amchagas/CellComunicationLab/media/assembly/clean/Drivers unlinked.tif

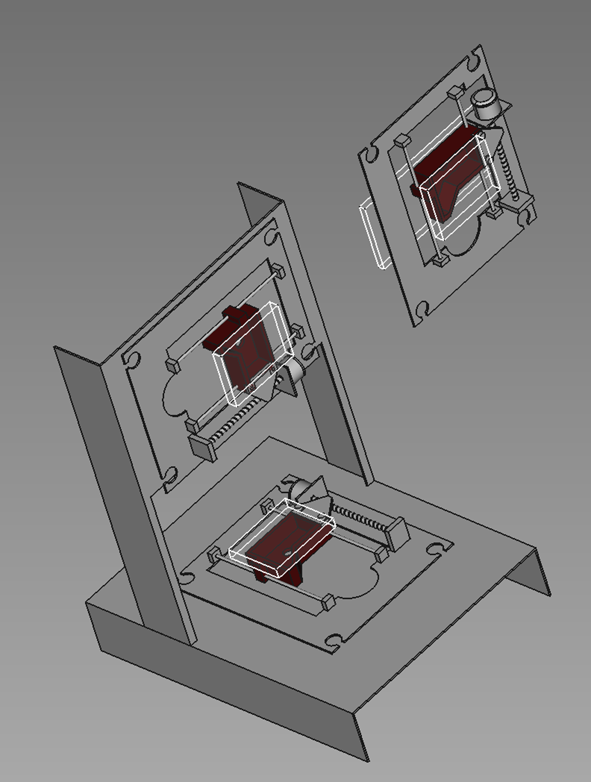
media/assembly/clean/Drivers unlinked.tif
