amchagas/CellComunicationLab/media/assembly/clean/Eletronic modules.tif

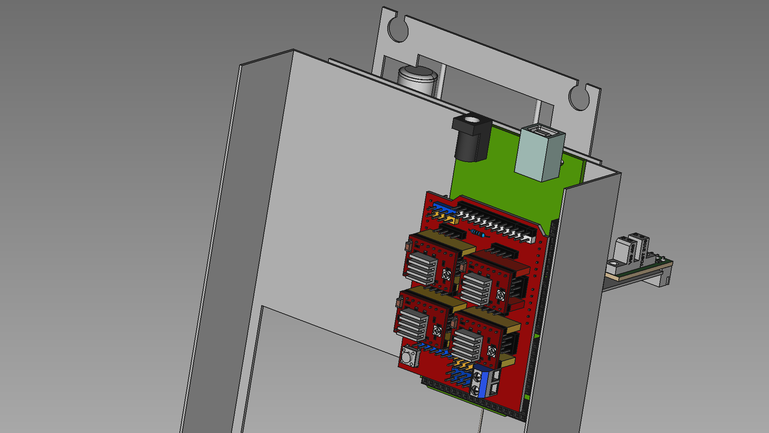
media/assembly/clean/Eletronic modules.tif
