amchagas/CellComunicationLab/media/assembly/clean/Frontal view.tif

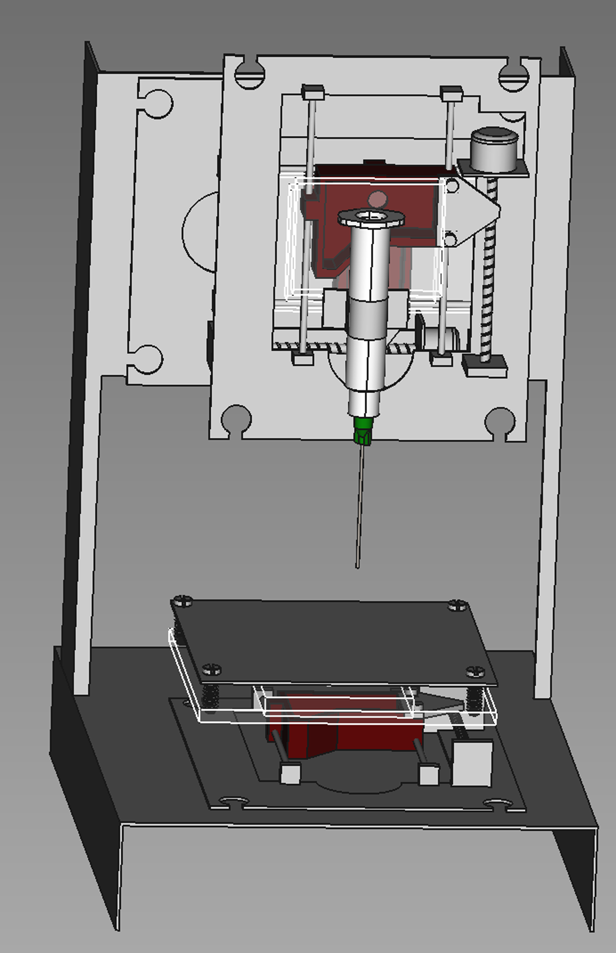
media/assembly/clean/Frontal view.tif
