amchagas/CellComunicationLab/media/assembly/clean/Initial assembly.tif

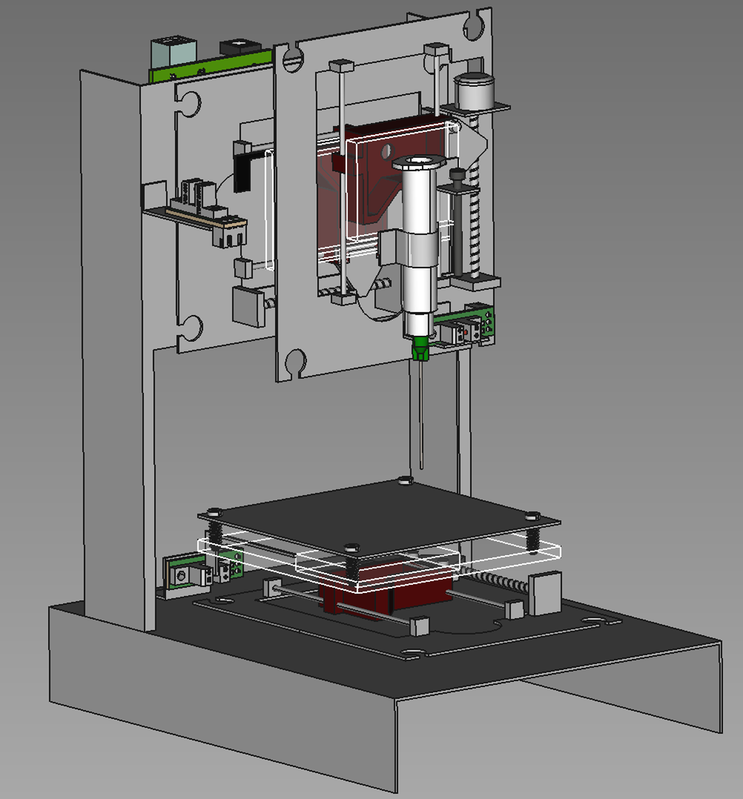
media/assembly/clean/Initial assembly.tif
