amchagas/CellComunicationLab/media/assembly/clean/Linked drivers.tif

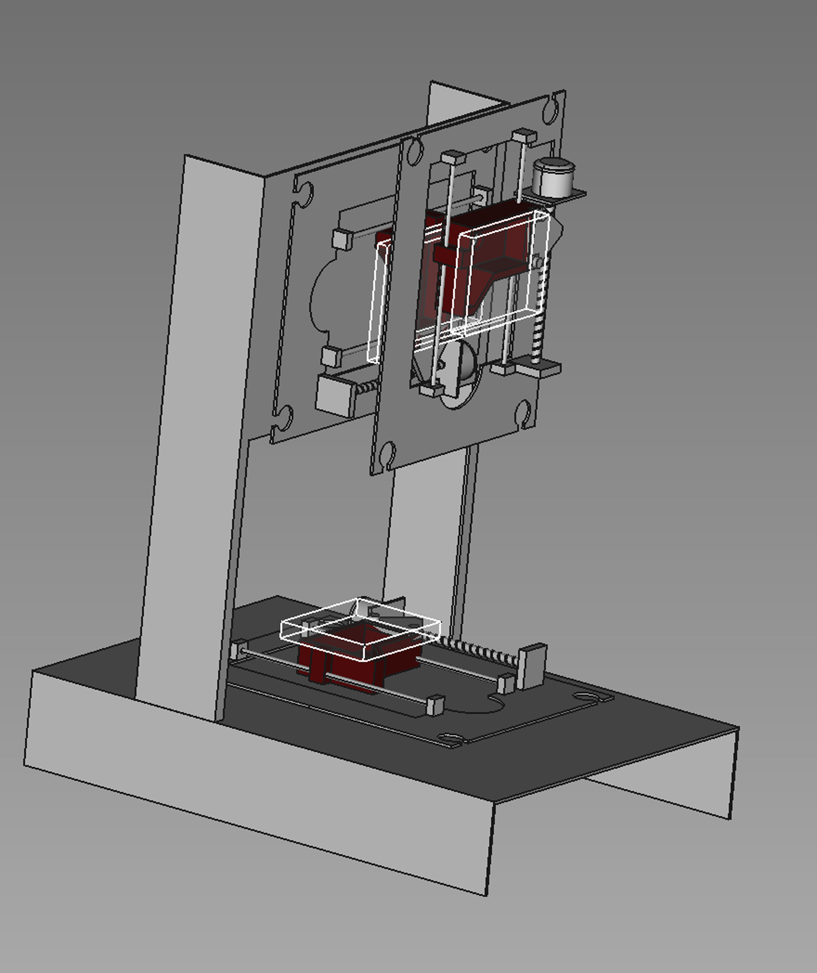
media/assembly/clean/Linked drivers.tif
