amchagas/CellComunicationLab/media/assembly/clean/Print table.tif

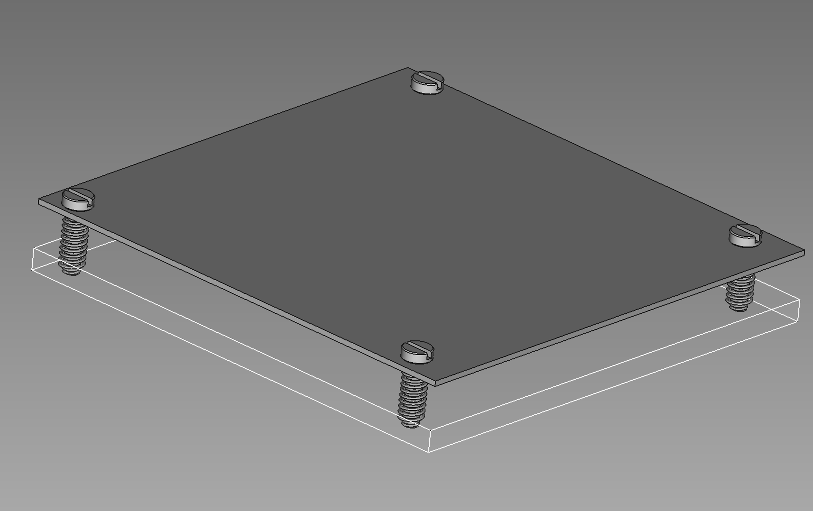
media/assembly/clean/Print table.tif
