amchagas/CellComunicationLab/media/assembly/legend/1 - Gatry image.tif

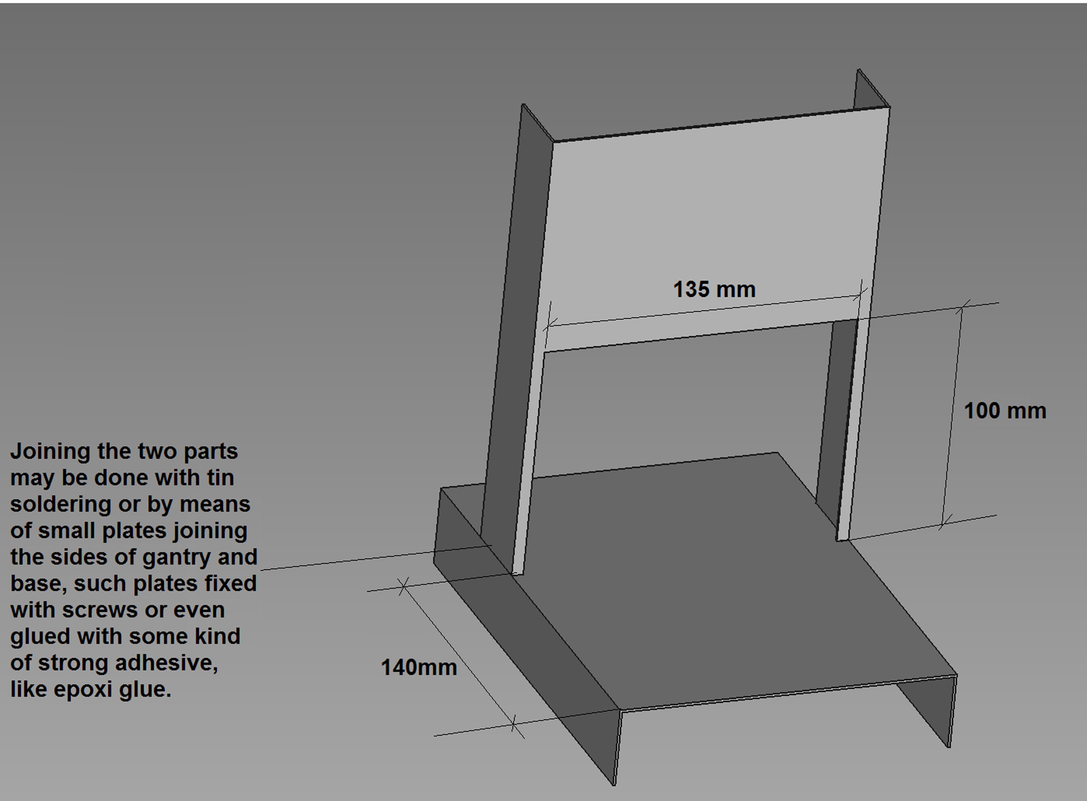
media/assembly/legend/1 - Gatry image.tif
