amchagas/CellComunicationLab/media/assembly/legend/2 - Driver view.tif

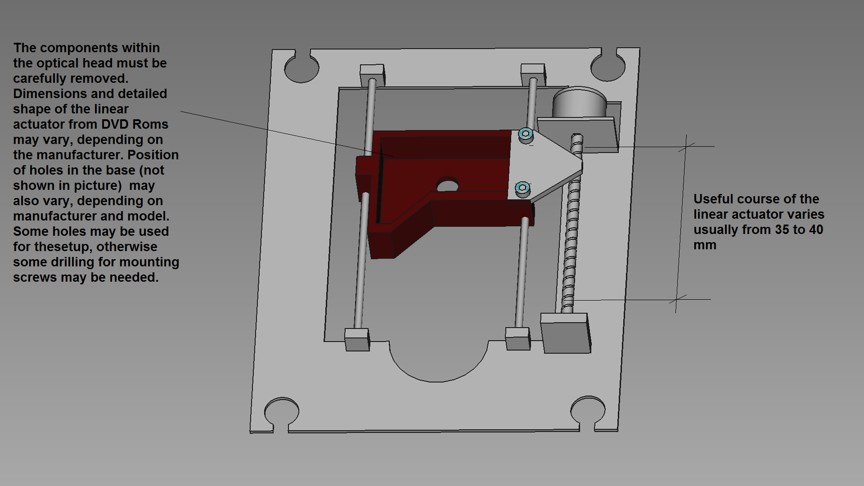
media/assembly/legend/2 - Driver view.tif
