amchagas/CellComunicationLab/media/assembly/legend/3-Drivers view compete axis.tif

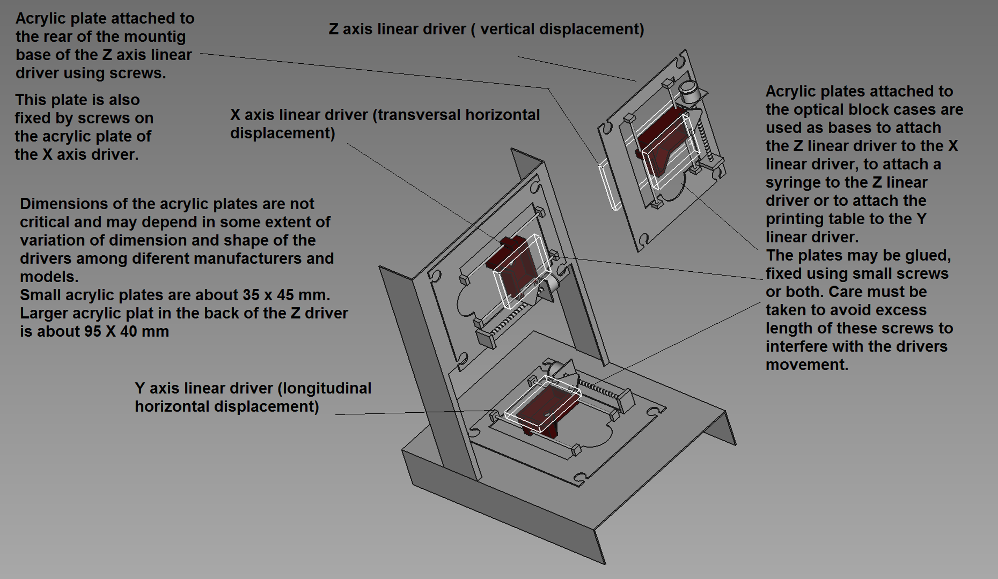
media/assembly/legend/3-Drivers view compete axis.tif
