amchagas/CellComunicationLab/media/assembly/legend/4 - Driver linked lateral view.tif

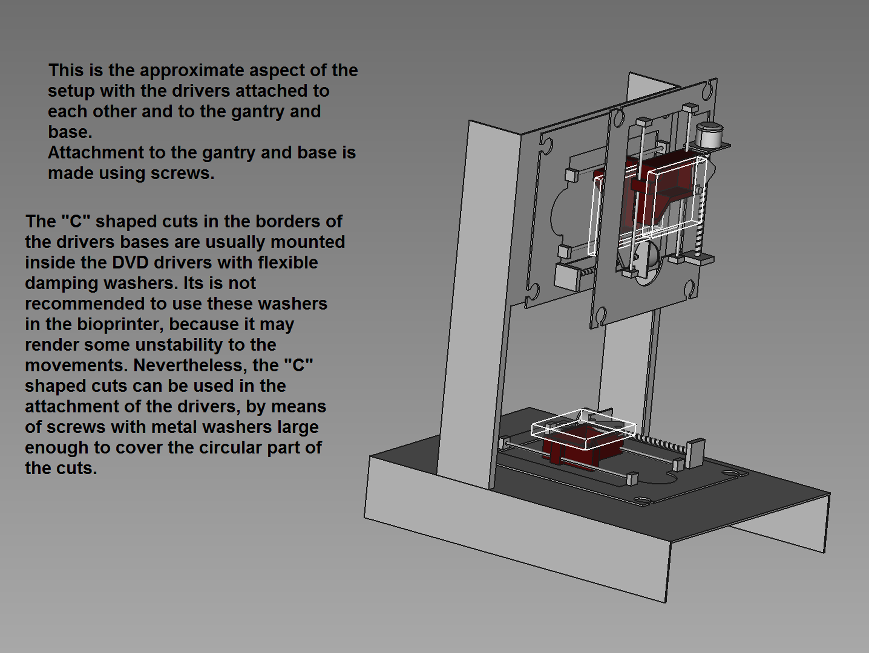
media/assembly/legend/4 - Driver linked lateral view.tif
