amchagas/CellComunicationLab/media/assembly/legend/5. Detailed table view.tif

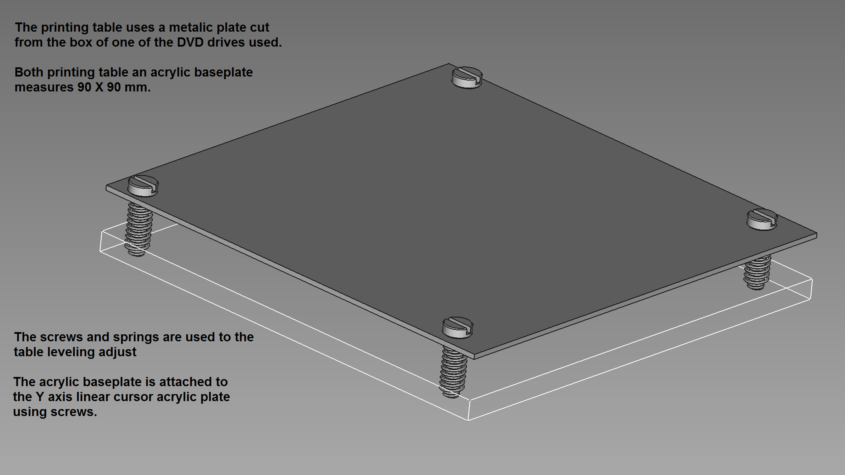
media/assembly/legend/5. Detailed table view.tif
