amchagas/CellComunicationLab/media/assembly/legend/6 - Initial assembly.tif

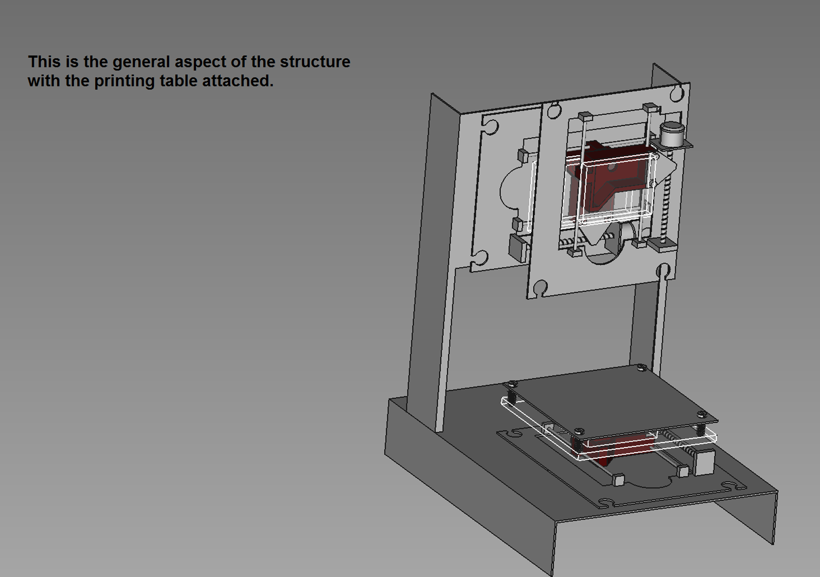
media/assembly/legend/6 - Initial assembly.tif
