amchagas/CellComunicationLab/media/assembly/legend/7 - Frontal view of bioprinter assembly.tif

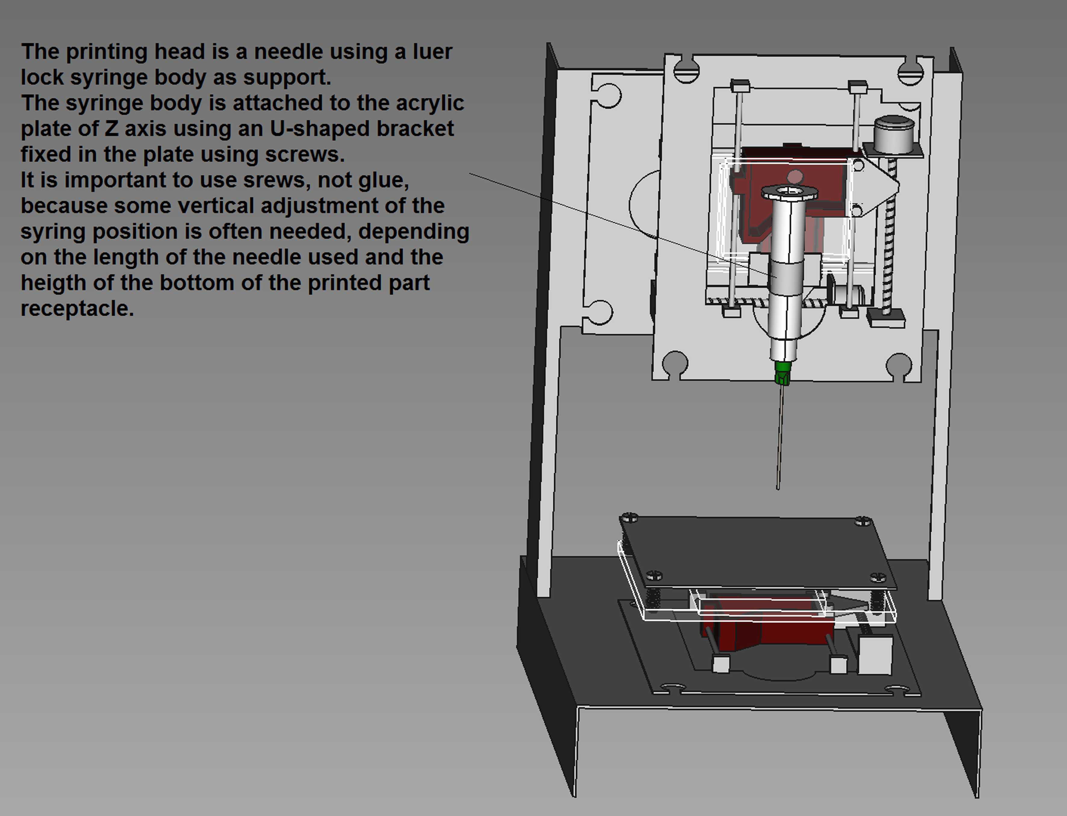
media/assembly/legend/7 - Frontal view of bioprinter assembly.tif
