amchagas/CellComunicationLab/media/assembly/legend/8 - Eletronic module.tif

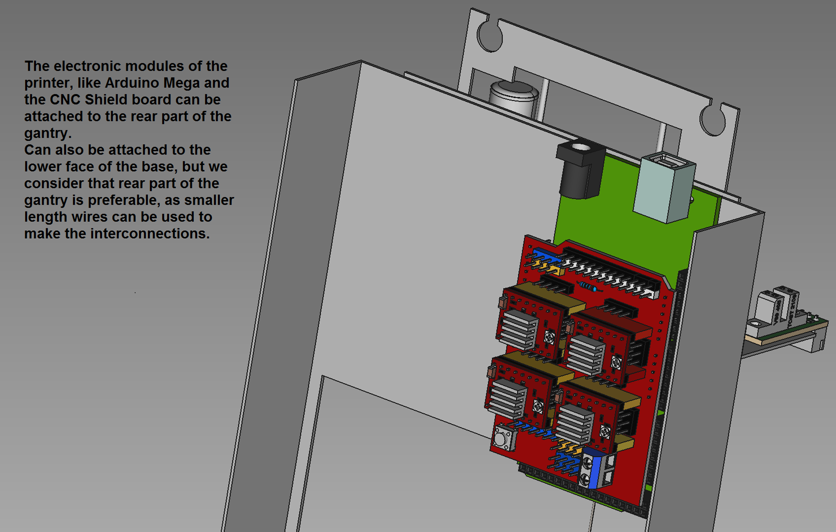
media/assembly/legend/8 - Eletronic module.tif
