amchagas/CellComunicationLab/media/assembly/legend/9 -End-stop sensors.tif

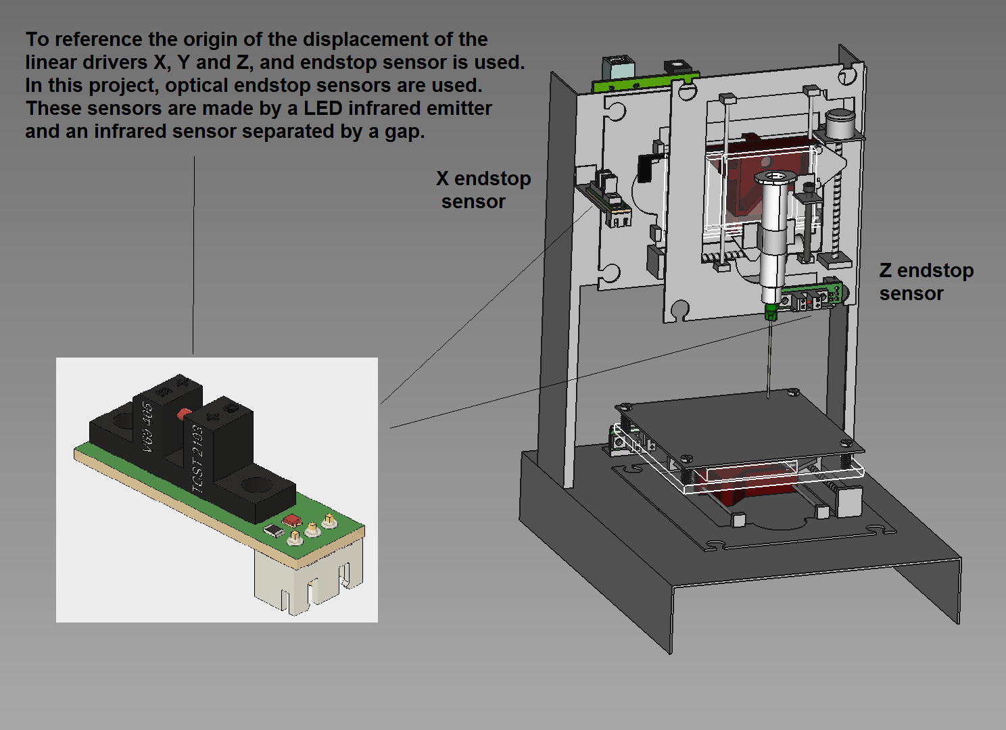
media/assembly/legend/9 -End-stop sensors.tif
