amchagas/CellComunicationLab/media/assembly/legend/10 -XZ axis end-stop sensors.tif

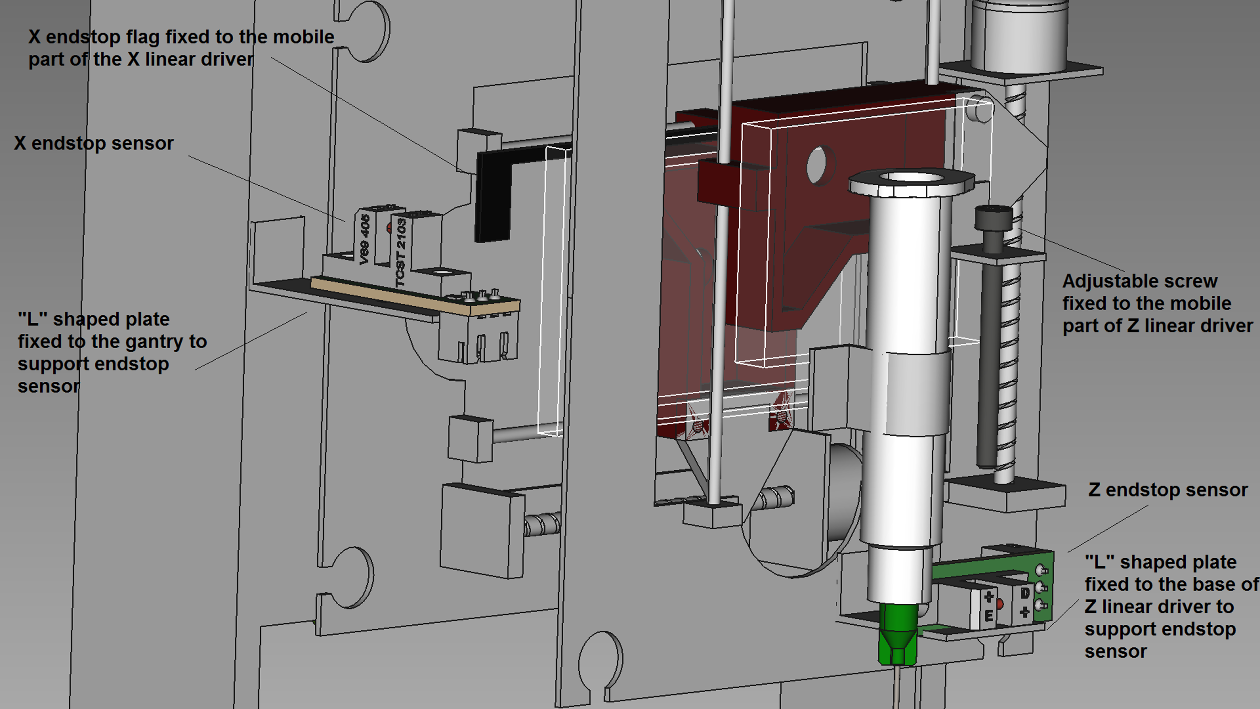
media/assembly/legend/10 -XZ axis end-stop sensors.tif
