amchagas/CellComunicationLab/media/assembly/legend/11 -Y axis end-stop sensor.tif

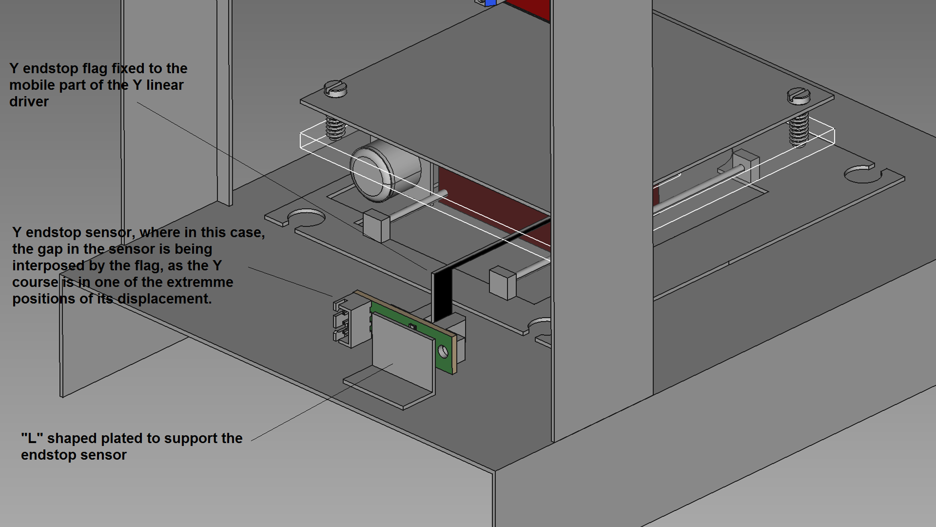
media/assembly/legend/11 -Y axis end-stop sensor.tif
