amchagas/CellComunicationLab/media/assembly/legend/12 - XYZ end-stop sensors position.tif

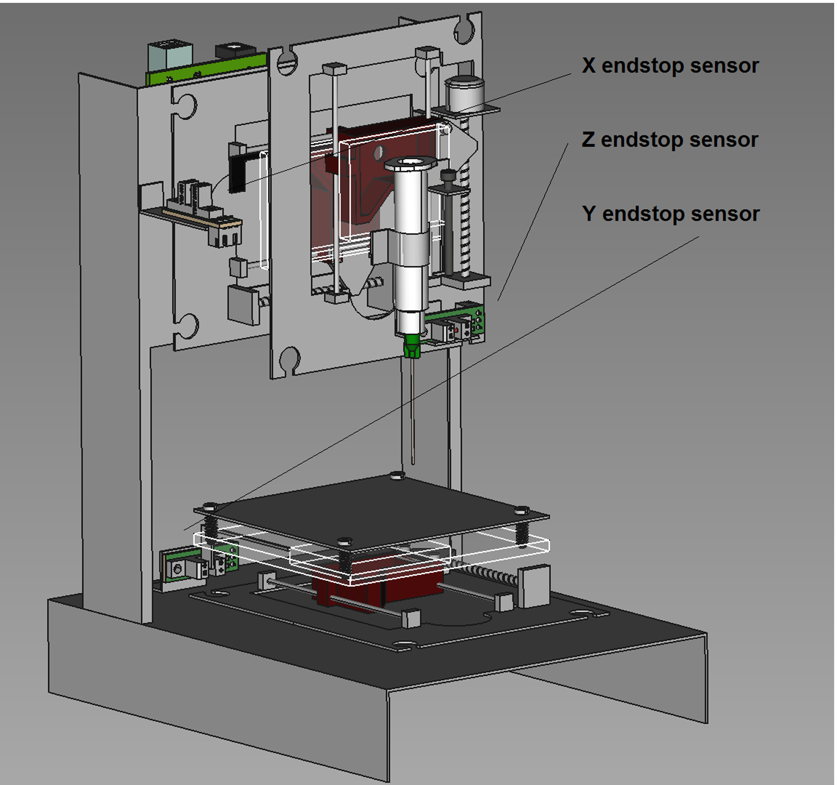
media/assembly/legend/12 - XYZ end-stop sensors position.tif
