amchagas/CellComunicationLab/software/Repetier/Configuration.h

#define CONFIGURATION_H
#define NUM_EXTRUDER 1
#define MOTHERBOARD 33
#include "pins.h"
#define HOST_RESCUE 1
#undef FAN_BOARD_PIN
#define FAN_BOARD_PIN 9 //-1
#define BOARD_FAN_SPEED 255
#define BOARD_FAN_MIN_SPEED 0
#define FAN_THERMO_PIN -1
#define FAN_THERMO_MIN_PWM 128
#define FAN_THERMO_MAX_PWM 255
#define FAN_THERMO_MIN_TEMP 45
#define FAN_THERMO_MAX_TEMP 60
#define FAN_THERMO_THERMISTOR_PIN -1
#define FAN_THERMO_THERMISTOR_TYPE 0
#undef X_MIN_PIN
#define X_MIN_PIN 3
#undef Y_MIN_PIN
#define Y_MIN_PIN 14
#undef Z_MIN_PIN
#define Z_MIN_PIN 18
#undef X_MAX_PIN
#define X_MAX_PIN 2
#undef Y_MAX_PIN
#define Y_MAX_PIN 15
#undef Z_MAX_PIN
#define Z_MAX_PIN 19
#define BLUETOOTH_SERIAL  -1
#define BLUETOOTH_BAUD  115200
#define MIXING_EXTRUDER 0
#define DRIVE_SYSTEM 0
#define XAXIS_STEPS_PER_MM 107
#define YAXIS_STEPS_PER_MM 104
#define ZAXIS_STEPS_PER_MM 107
#define EXTRUDER_FAN_COOL_TEMP 50
#define PDM_FOR_EXTRUDER 0
#define PDM_FOR_COOLER 0
#define DECOUPLING_TEST_MAX_HOLD_VARIANCE 20
#define DECOUPLING_TEST_MIN_TEMP_RISE 1
#define KILL_IF_SENSOR_DEFECT 0
#define RETRACT_ON_PAUSE 0
#define PAUSE_START_COMMANDS ""
#define PAUSE_END_COMMANDS ""
#define SHARED_EXTRUDER_HEATER 0
#define EXT0_X_OFFSET 0
#define EXT0_Y_OFFSET 0
#define EXT0_Z_OFFSET 0
#define EXT0_STEPS_PER_MM 4000
#define EXT0_TEMPSENSOR_TYPE 0
#define EXT0_TEMPSENSOR_PIN -1
#define EXT0_HEATER_PIN -1
#define EXT0_STEP_PIN ORIG_E0_STEP_PIN
#define EXT0_DIR_PIN ORIG_E0_DIR_PIN
#define EXT0_INVERSE 0
#define EXT0_ENABLE_PIN ORIG_E0_ENABLE_PIN
#define EXT0_ENABLE_ON 0
#define EXT0_MIRROR_STEPPER 0
#define EXT0_STEP2_PIN ORIG_E0_STEP_PIN
#define EXT0_DIR2_PIN ORIG_E0_DIR_PIN
#define EXT0_INVERSE2 0
#define EXT0_ENABLE2_PIN ORIG_E0_ENABLE_PIN
#define EXT0_MAX_FEEDRATE 0.165
#define EXT0_MAX_START_FEEDRATE 0.1
#define EXT0_MAX_ACCELERATION 20
#define EXT0_HEAT_MANAGER 0
#define EXT0_PREHEAT_TEMP 20
#define EXT0_WATCHPERIOD 1
#define EXT0_PID_INTEGRAL_DRIVE_MAX 230
#define EXT0_PID_INTEGRAL_DRIVE_MIN 40
#define EXT0_PID_PGAIN_OR_DEAD_TIME 7
#define EXT0_PID_I 2
#define EXT0_PID_D 40
#define EXT0_PID_MAX 0
#define EXT0_ADVANCE_K 0
#define EXT0_ADVANCE_L 0
#define EXT0_ADVANCE_BACKLASH_STEPS 0
#define EXT0_WAIT_RETRACT_TEMP 150
#define EXT0_WAIT_RETRACT_UNITS 0
#define EXT0_SELECT_COMMANDS ""
#define EXT0_DESELECT_COMMANDS ""
#define EXT0_EXTRUDER_COOLER_PIN -1
#define EXT0_EXTRUDER_COOLER_SPEED 255
#define EXT0_DECOUPLE_TEST_PERIOD 0
#define EXT0_JAM_PIN -1
#define EXT0_JAM_PULLUP 0
#define FEATURE_RETRACTION 1
#define AUTORETRACT_ENABLED 0
#define RETRACTION_LENGTH 0
#define RETRACTION_LONG_LENGTH 0
#define RETRACTION_SPEED 40
#define RETRACTION_Z_LIFT 0
#define RETRACTION_UNDO_EXTRA_LENGTH 0
#define RETRACTION_UNDO_EXTRA_LONG_LENGTH 0
#define RETRACTION_UNDO_SPEED 20
#define FILAMENTCHANGE_X_POS 0
#define FILAMENTCHANGE_Y_POS 0
#define FILAMENTCHANGE_Z_ADD  2
#define FILAMENTCHANGE_REHOME 1
#define FILAMENTCHANGE_SHORTRETRACT 5
#define FILAMENTCHANGE_LONGRETRACT 50
#define JAM_METHOD 3
#define JAM_STEPS 220
#define JAM_SLOWDOWN_STEPS 320
#define JAM_SLOWDOWN_TO 70
#define JAM_ERROR_STEPS 500
#define JAM_MIN_STEPS 10
#define JAM_ACTION 2
#define RETRACT_DURING_HEATUP true
#define PID_CONTROL_RANGE 20
#define SKIP_M109_IF_WITHIN 2
#define SCALE_PID_TO_MAX 0
#define TEMP_HYSTERESIS 0
#define EXTRUDE_MAXLENGTH 40
#define NUM_TEMPS_USERTHERMISTOR0 0
#define USER_THERMISTORTABLE0 {}
#define NUM_TEMPS_USERTHERMISTOR1 0
#define USER_THERMISTORTABLE1 {}
#define NUM_TEMPS_USERTHERMISTOR2 0
#define USER_THERMISTORTABLE2 {}
#define GENERIC_THERM_VREF 5
#define GENERIC_THERM_NUM_ENTRIES 33
#define TEMP_GAIN 0
#define HEATER_PWM_SPEED 0
#define COOLER_PWM_SPEED 0
#define HAVE_HEATED_BED 0
#define HEATED_BED_PREHEAT_TEMP 55
#define HEATED_BED_MAX_TEMP 120
#define SKIP_M190_IF_WITHIN 3
#define HEATED_BED_SENSOR_TYPE 1
#define HEATED_BED_SENSOR_PIN TEMP_1_PIN
#define HEATED_BED_HEATER_PIN HEATER_1_PIN
#define HEATED_BED_SET_INTERVAL 5000
#define HEATED_BED_HEAT_MANAGER 0
#define HEATED_BED_PID_INTEGRAL_DRIVE_MAX 255
#define HEATED_BED_PID_INTEGRAL_DRIVE_MIN 80
#define HEATED_BED_PID_PGAIN_OR_DEAD_TIME   196
#define HEATED_BED_PID_IGAIN   33
#define HEATED_BED_PID_DGAIN 290
#define HEATED_BED_PID_MAX 255
#define HEATED_BED_DECOUPLE_TEST_PERIOD 300000
#define MIN_EXTRUDER_TEMP 25
#define MAXTEMP 25
#define MIN_DEFECT_TEMPERATURE -10
#define MAX_DEFECT_TEMPERATURE 25
#define MILLISECONDS_PREHEAT_TIME 30000
#define SUPPORT_LASER 0
#define LASER_PIN -1
#define LASER_ON_HIGH 1
#define LASER_WARMUP_TIME 0
#define LASER_PWM_MAX 255
#define LASER_WATT 2
#define SUPPORT_CNC 0
#define CNC_WAIT_ON_ENABLE 300
#define CNC_WAIT_ON_DISABLE 0
#define CNC_ENABLE_PIN -1
#define CNC_ENABLE_WITH 1
#define CNC_DIRECTION_PIN -1
#define CNC_DIRECTION_CW 1
#define CNC_PWM_MAX 255
#define CNC_RPM_MAX 8000
#define CNC_SAFE_Z 150
#define DEFAULT_PRINTER_MODE 0
#define MULTI_ZENDSTOP_HOMING 0
#define ENDSTOP_PULLUP_X_MIN false
#define ENDSTOP_X_MIN_INVERTING false
#define MIN_HARDWARE_ENDSTOP_X true
#define ENDSTOP_PULLUP_Y_MIN false
#define ENDSTOP_Y_MIN_INVERTING false
#define MIN_HARDWARE_ENDSTOP_Y true
#define ENDSTOP_PULLUP_Z_MIN false
#define ENDSTOP_Z_MIN_INVERTING false
#define MIN_HARDWARE_ENDSTOP_Z true
#define ENDSTOP_PULLUP_Z2_MINMAX true
#define ENDSTOP_Z2_MINMAX_INVERTING false
#define MINMAX_HARDWARE_ENDSTOP_Z2 false
#define ENDSTOP_PULLUP_X_MAX false
#define ENDSTOP_X_MAX_INVERTING false
#define MAX_HARDWARE_ENDSTOP_X true
#define ENDSTOP_PULLUP_Y_MAX false
#define ENDSTOP_Y_MAX_INVERTING false
#define MAX_HARDWARE_ENDSTOP_Y true
#define ENDSTOP_PULLUP_Z_MAX false
#define ENDSTOP_Z_MAX_INVERTING false
#define MAX_HARDWARE_ENDSTOP_Z true
#define ENDSTOP_PULLUP_X2_MIN false
#define ENDSTOP_PULLUP_Y2_MIN false
#define ENDSTOP_PULLUP_Z2_MINMAX false
#define ENDSTOP_PULLUP_X2_MAX false
#define ENDSTOP_PULLUP_Y2_MAX false
#define ENDSTOP_X2_MIN_INVERTING false
#define ENDSTOP_Y2_MIN_INVERTING false
#define ENDSTOP_X2_MAX_INVERTING false
#define ENDSTOP_Y2_MAX_INVERTING false
#define MIN_HARDWARE_ENDSTOP_X2 false
#define MIN_HARDWARE_ENDSTOP_Y2 false
#define MAX_HARDWARE_ENDSTOP_X2 false
#define MAX_HARDWARE_ENDSTOP_Y2 false
#define X2_MIN_PIN -1
#define X2_MAX_PIN -1
#define Y2_MIN_PIN -1
#define Y2_MAX_PIN -1
#define Z2_MINMAX_PIN -1
#define max_software_endstop_r true
#define min_software_endstop_x false
#define min_software_endstop_y false
#define min_software_endstop_z false
#define max_software_endstop_x false
#define max_software_endstop_y false
#define max_software_endstop_z false
#define DOOR_PIN -1
#define DOOR_PULLUP 1
#define DOOR_INVERTING 0
#define ENDSTOP_X_BACK_MOVE 5
#define ENDSTOP_Y_BACK_MOVE 5
#define ENDSTOP_Z_BACK_MOVE 2
#define ENDSTOP_X_RETEST_REDUCTION_FACTOR 3
#define ENDSTOP_Y_RETEST_REDUCTION_FACTOR 3
#define ENDSTOP_Z_RETEST_REDUCTION_FACTOR 3
#define ENDSTOP_X_BACK_ON_HOME 1
#define ENDSTOP_Y_BACK_ON_HOME 1
#define ENDSTOP_Z_BACK_ON_HOME 0
#define ALWAYS_CHECK_ENDSTOPS 1
#define MOVE_X_WHEN_HOMED 0
#define MOVE_Y_WHEN_HOMED 0
#define MOVE_Z_WHEN_HOMED 0
#define X_ENABLE_ON 0
#define Y_ENABLE_ON 0
#define Z_ENABLE_ON 0
#define DISABLE_X 0
#define DISABLE_Y 0
#define DISABLE_Z 0
#define DISABLE_E 0
#define INVERT_X_DIR 1
#define INVERT_X2_DIR 0
#define INVERT_Y_DIR 1
#define INVERT_Y2_DIR 0
#define INVERT_Z_DIR 1
#define INVERT_Z2_DIR 0
#define INVERT_Z3_DIR 0
#define INVERT_Z4_DIR 0
#define X_HOME_DIR -1
#define Y_HOME_DIR -1
#define Z_HOME_DIR -1
#define X_MAX_LENGTH 36
#define Y_MAX_LENGTH 36
#define Z_MAX_LENGTH 25
#define X_MIN_POS 0
#define Y_MIN_POS 0
#define Z_MIN_POS 0
#define PARK_POSITION_X 0
#define PARK_POSITION_Y 0
#define PARK_POSITION_Z_RAISE 0
#define DISTORTION_CORRECTION 0
#define DISTORTION_CORRECTION_POINTS 5
#define DISTORTION_LIMIT_TO 2
#define DISTORTION_CORRECTION_R 100
#define DISTORTION_PERMANENT 0
#define DISTORTION_UPDATE_FREQUENCY 15
#define DISTORTION_START_DEGRADE 0.5
#define DISTORTION_END_HEIGHT 1
#define DISTORTION_EXTRAPOLATE_CORNERS 0
#define DISTORTION_XMIN 10
#define DISTORTION_YMIN 10
#define DISTORTION_XMAX 190
#define DISTORTION_YMAX 190
#define FEATURE_BABYSTEPPING 0
#define BABYSTEP_MULTIPLICATOR 1
#define DELTA_SEGMENTS_PER_SECOND_PRINT 180 // Move accurate setting for print moves
#define DELTA_SEGMENTS_PER_SECOND_MOVE 70 // Less accurate setting for other moves
#define EXACT_DELTA_MOVES 1
#define DELTA_HOME_ON_POWER 0
#define DELTASEGMENTS_PER_PRINTLINE 20
#define STEPPER_INACTIVE_TIME 360L
#define MAX_INACTIVE_TIME 0L
#define MAX_FEEDRATE_X 120
#define MAX_FEEDRATE_Y 120
#define MAX_FEEDRATE_Z 120
#define HOMING_FEEDRATE_X 40
#define HOMING_FEEDRATE_Y 40
#define HOMING_FEEDRATE_Z 40
#define HOMING_ORDER HOME_ORDER_XYZ
#define ZHOME_PRE_RAISE 2
#define ZHOME_PRE_RAISE_DISTANCE 10
#define RAISE_Z_ON_TOOLCHANGE 0
#define ZHOME_MIN_TEMPERATURE 0
#define ZHOME_HEAT_ALL 1
#define ZHOME_HEAT_HEIGHT 20
#define ZHOME_X_POS 999999
#define ZHOME_Y_POS 999999
#define ENABLE_BACKLASH_COMPENSATION 0
#define X_BACKLASH 0
#define Y_BACKLASH 0
#define Z_BACKLASH 0
#define RAMP_ACCELERATION 1
#define STEPPER_HIGH_DELAY 0
#define DIRECTION_DELAY 0
#define STEP_DOUBLER_FREQUENCY 12000
#define ALLOW_QUADSTEPPING 1
#define DOUBLE_STEP_DELAY 0 // time in microseconds
#define MAX_ACCELERATION_UNITS_PER_SQ_SECOND_X 700
#define MAX_ACCELERATION_UNITS_PER_SQ_SECOND_Y 700
#define MAX_ACCELERATION_UNITS_PER_SQ_SECOND_Z 700
#define MAX_TRAVEL_ACCELERATION_UNITS_PER_SQ_SECOND_X 700
#define MAX_TRAVEL_ACCELERATION_UNITS_PER_SQ_SECOND_Y 700
#define MAX_TRAVEL_ACCELERATION_UNITS_PER_SQ_SECOND_Z 700
#define INTERPOLATE_ACCELERATION_WITH_Z 0
#define ACCELERATION_FACTOR_TOP 100
#define MAX_JERK 20
#define MAX_ZJERK 0.3
#define PRINTLINE_CACHE_SIZE 16
#define MOVE_CACHE_LOW 10
#define LOW_TICKS_PER_MOVE 250000
#define EXTRUDER_SWITCH_XY_SPEED 100
#define DUAL_X_AXIS 0
#define DUAL_X_RESOLUTION 0
#define X2AXIS_STEPS_PER_MM 100
#define FEATURE_TWO_XSTEPPER 0
#define X2_STEP_PIN   ORIG_E1_STEP_PIN
#define X2_DIR_PIN    ORIG_E1_DIR_PIN
#define X2_ENABLE_PIN ORIG_E1_ENABLE_PIN
#define FEATURE_TWO_YSTEPPER 0
#define Y2_STEP_PIN   ORIG_E1_STEP_PIN
#define Y2_DIR_PIN    ORIG_E1_DIR_PIN
#define Y2_ENABLE_PIN ORIG_E1_ENABLE_PIN
#define FEATURE_TWO_ZSTEPPER 0
#define Z2_STEP_PIN   ORIG_E1_STEP_PIN
#define Z2_DIR_PIN    ORIG_E1_DIR_PIN
#define Z2_ENABLE_PIN ORIG_E1_ENABLE_PIN
#define FEATURE_THREE_ZSTEPPER 0
#define Z3_STEP_PIN   ORIG_E2_STEP_PIN
#define Z3_DIR_PIN    ORIG_E2_DIR_PIN
#define Z3_ENABLE_PIN ORIG_E2_ENABLE_PIN
#define FEATURE_FOUR_ZSTEPPER 0
#define Z4_STEP_PIN   ORIG_E3_STEP_PIN
#define Z4_DIR_PIN    ORIG_E3_DIR_PIN
#define Z4_ENABLE_PIN ORIG_E3_ENABLE_PIN
#define FEATURE_DITTO_PRINTING 0
#define USE_ADVANCE 0
#define ENABLE_QUADRATIC_ADVANCE 0
#define BAUDRATE 250000
#define ENABLE_POWER_ON_STARTUP 1
#define POWER_INVERTING 0
#define AUTOMATIC_POWERUP 0
#define KILL_METHOD 1
#define EMERGENCY_PARSER 0
#define ACK_WITH_LINENUMBER 1
#define KEEP_ALIVE_INTERVAL 2000
#define WAITING_IDENTIFIER "wait"
#define ECHO_ON_EXECUTE 1
#define EEPROM_MODE 1
#undef PS_ON_PIN
#define PS_ON_PIN -1
#define JSON_OUTPUT 0
#define FEATURE_SERVO 0
#define SERVO0_PIN 11
#define SERVO1_PIN -1
#define SERVO2_PIN -1
#define SERVO3_PIN -1
#define SERVO0_NEUTRAL_POS  -1
#define SERVO1_NEUTRAL_POS  -1
#define SERVO2_NEUTRAL_POS  -1
#define SERVO3_NEUTRAL_POS  -1
#define UI_SERVO_CONTROL 0
#define FAN_KICKSTART_TIME  0
#define MAX_FAN_PWM  255 //0
        #define FEATURE_WATCHDOG 0
#define Z_PROBE_Z_OFFSET 0
#define Z_PROBE_Z_OFFSET_MODE 0
#define UI_BED_COATING 1
#define FEATURE_Z_PROBE 0
#define EXTRUDER_IS_Z_PROBE 0
#define Z_PROBE_DISABLE_HEATERS 0
#define Z_PROBE_BED_DISTANCE 10
#define Z_PROBE_PIN -1
#define Z_PROBE_PULLUP 0
#define Z_PROBE_ON_HIGH 0
#define Z_PROBE_X_OFFSET 0
#define Z_PROBE_Y_OFFSET 0
#define Z_PROBE_WAIT_BEFORE_TEST 0
#define Z_PROBE_SPEED 2
#define Z_PROBE_XY_SPEED 150
#define Z_PROBE_SWITCHING_DISTANCE 1
#define Z_PROBE_REPETITIONS 1
#define Z_PROBE_USE_MEDIAN 0
#define Z_PROBE_HEIGHT 40
#define Z_PROBE_DELAY 0
#define Z_PROBE_START_SCRIPT ""
#define Z_PROBE_FINISHED_SCRIPT ""
#define Z_PROBE_RUN_AFTER_EVERY_PROBE ""
#define Z_PROBE_REQUIRES_HEATING 0
#define Z_PROBE_MIN_TEMPERATURE 150
#define FEATURE_AUTOLEVEL 0
#define FEATURE_SOFTWARE_LEVELING 0
#define Z_PROBE_X1 20
#define Z_PROBE_Y1 20
#define Z_PROBE_X2 160
#define Z_PROBE_Y2 20
#define Z_PROBE_X3 20
#define Z_PROBE_Y3 160
#define BED_LEVELING_METHOD 0
#define BED_CORRECTION_METHOD 0
#define BED_LEVELING_GRID_SIZE 5
#define BED_LEVELING_REPETITIONS 5
#define BED_MOTOR_1_X 0
#define BED_MOTOR_1_Y 0
#define BED_MOTOR_2_X 200
#define BED_MOTOR_2_Y 0
#define BED_MOTOR_3_X 100
#define BED_MOTOR_3_Y 200
#define BENDING_CORRECTION_A 0
#define BENDING_CORRECTION_B 0
#define BENDING_CORRECTION_C 0
#define FEATURE_AXISCOMP 0
#define AXISCOMP_TANXY 0
#define AXISCOMP_TANYZ 0
#define AXISCOMP_TANXZ 0
#define SDSUPPORT 0
#undef SDCARDDETECT
#define SDCARDDETECT -1
#undef SDCARDDETECTINVERTED
#define SDCARDDETECTINVERTED 0
#define SD_EXTENDED_DIR 1
#define SD_RUN_ON_STOP ""
#define SD_STOP_HEATER_AND_MOTORS_ON_STOP 0
#define ARC_SUPPORT 0
#define FEATURE_MEMORY_POSITION 0
#define FEATURE_CHECKSUM_FORCED 0
#define FEATURE_FAN_CONTROL 1
#define FEATURE_FAN2_CONTROL 0
#define FEATURE_CONTROLLER 0
#define ADC_KEYPAD_PIN -1
#define LANGUAGE_EN_ACTIVE 1
#define LANGUAGE_DE_ACTIVE 1
#define LANGUAGE_NL_ACTIVE 0
#define LANGUAGE_PT_ACTIVE 1
#define LANGUAGE_IT_ACTIVE 1
#define LANGUAGE_ES_ACTIVE 1
#define LANGUAGE_FI_ACTIVE 0
#define LANGUAGE_SE_ACTIVE 0
#define LANGUAGE_FR_ACTIVE 1
#define LANGUAGE_CZ_ACTIVE 0
#define LANGUAGE_PL_ACTIVE 1
#define LANGUAGE_TR_ACTIVE 1
#define LANGUAGE_RU_ACTIVE 0
#define UI_PRINTER_NAME "RepRap"
#define UI_PRINTER_COMPANY "Home made"
#define UI_PAGES_DURATION 4000
#define UI_SPEEDDEPENDENT_POSITIONING 0
#define UI_DISABLE_AUTO_PAGESWITCH 1
#define UI_AUTORETURN_TO_MENU_AFTER 30000
#define FEATURE_UI_KEYS 0
#define UI_ENCODER_SPEED 1
#define UI_REVERSE_ENCODER 0
#define UI_KEY_BOUNCETIME 10
#define UI_KEY_FIRST_REPEAT 500
#define UI_KEY_REDUCE_REPEAT 50
#define UI_KEY_MIN_REPEAT 50
#define FEATURE_BEEPER 0
#define CASE_LIGHTS_PIN -1
#define CASE_LIGHT_DEFAULT_ON 1
#define UI_START_SCREEN_DELAY 1000
#define UI_DYNAMIC_ENCODER_SPEED 1
#define BEEPER_SHORT_SEQUENCE 2,2
#define BEEPER_LONG_SEQUENCE 8,8
#define UI_SET_MIN_HEATED_BED_TEMP  30
#define UI_SET_MAX_HEATED_BED_TEMP 120
#define UI_SET_MIN_EXTRUDER_TEMP   170
#define UI_SET_MAX_EXTRUDER_TEMP   260
#define UI_SET_EXTRUDER_FEEDRATE 2
#define UI_SET_EXTRUDER_RETRACT_DISTANCE 3
#define NUM_MOTOR_DRIVERS 0
